nnhoang215/COVID-19-Safety-Device/README.md

# COVID-19-Safety-Device



https://github.com/nnhoang215/COVID-19-Safety-Device/assets/83194656/6477c47e-f955-43d8-8ce9-02b5049aa1a3
